Sandsara/Sandsara-3D/README.md

# Sandsara-3D
Welcome to Sandsara's 3D models repo! Here you can find the mechanism desing in stp. 



## License

<br />This work is licensed under a <a rel="license" href="http://creativecommons.org/licenses/by-nc-nd/4.0/">Creative Commons Attribution-NonCommercial-NoDerivatives 4.0 International License</a>
