Sandsara/Sandsara-3D/Arms/Main-Arm-REL1.stp

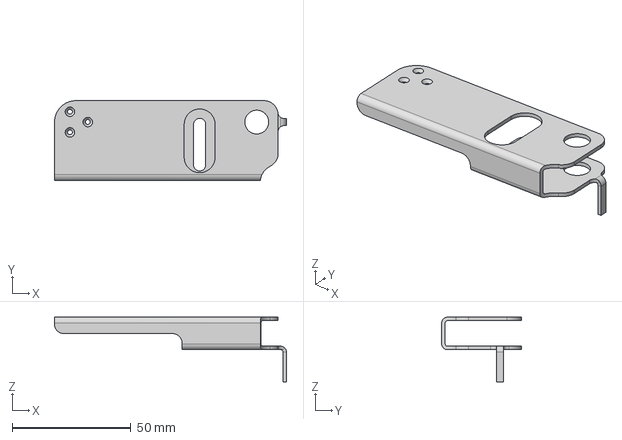
[picture p2: CAD file, 2021-05-29]
Arms/Main-Arm-REL1.stp
97.5 x 33.5 x 27.2 mm
