Sandsara/Sandsara-3D/Core/Main-Shaft-REL1.stp

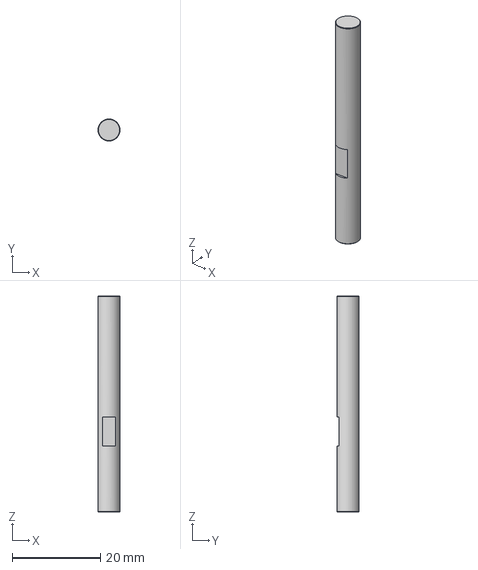
[picture p3: CAD file, 2021-05-29]
Core/Main-Shaft-REL1.stp
5.00 x 5.00 x 49.0 mm
