Sandsara/Sandsara-3D/Arms/Magnet-Arm-REL1.stp

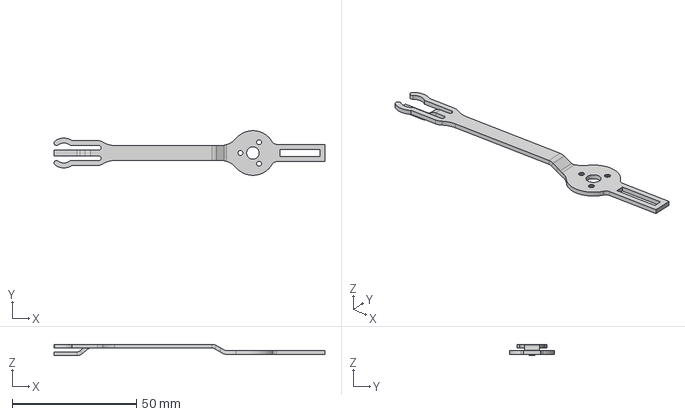
[picture p4: CAD file, 2021-05-29]
Arms/Magnet-Arm-REL1.stp
109.0 x 18.0 x 4.50 mm
