Sandsara/Sandsara-3D/Core/Pulley-40T-Bearing-REL1.stp

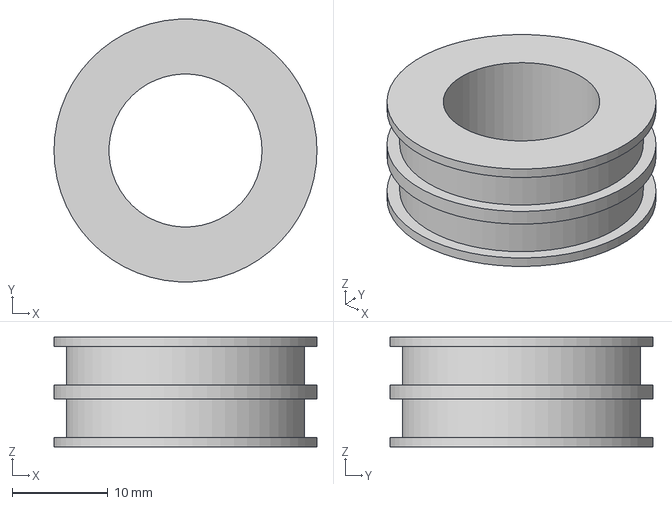
[picture p5: CAD file, 2021-05-29]
Core/Pulley-40T-Bearing-REL1.stp
27.5 x 27.5 x 11.5 mm
