Sandsara/Sandsara-3D/Core/Stepper-Holder-REL1.stp

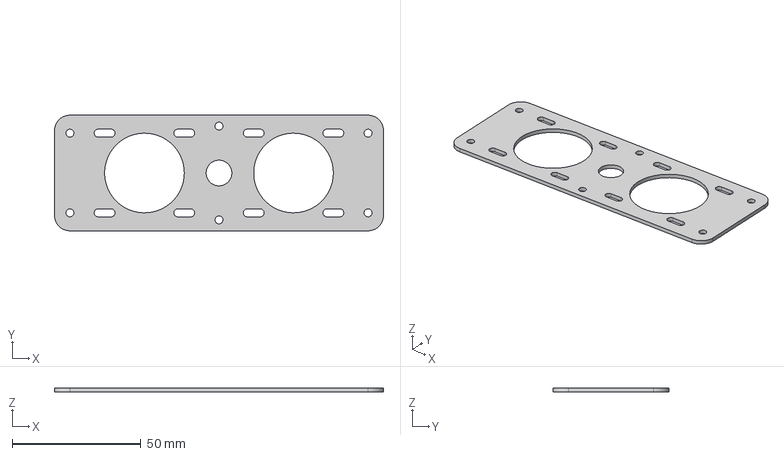
[picture p6: CAD file, 2021-05-29]
Core/Stepper-Holder-REL1.stp
128.0 x 45.0 x 1.59 mm
