Sandsara/Sandsara-3D/Arms/Magnet-Cap-REL1.stp

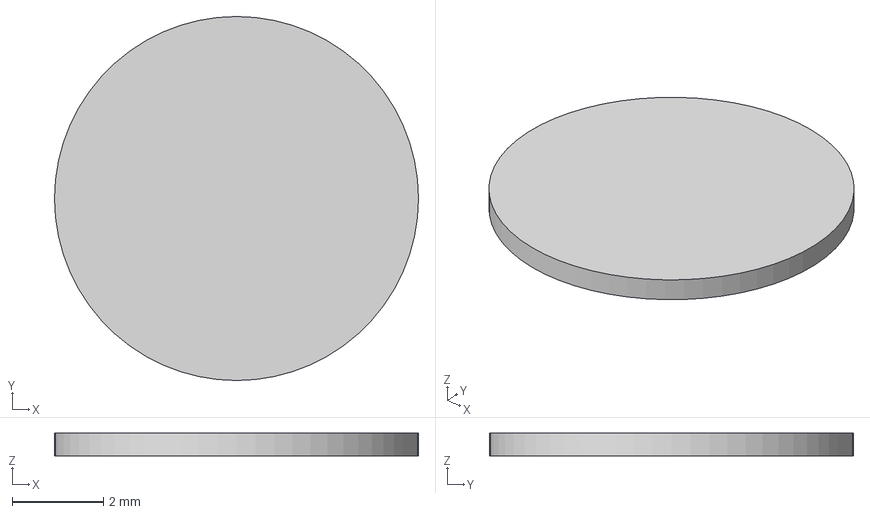
[picture p7: CAD file, 2021-05-29]
Arms/Magnet-Cap-REL1.stp
8.00 x 8.00 x 0.5 mm
