Sandsara/Sandsara-3D/Arms/Magnet-Large-REL1.stp

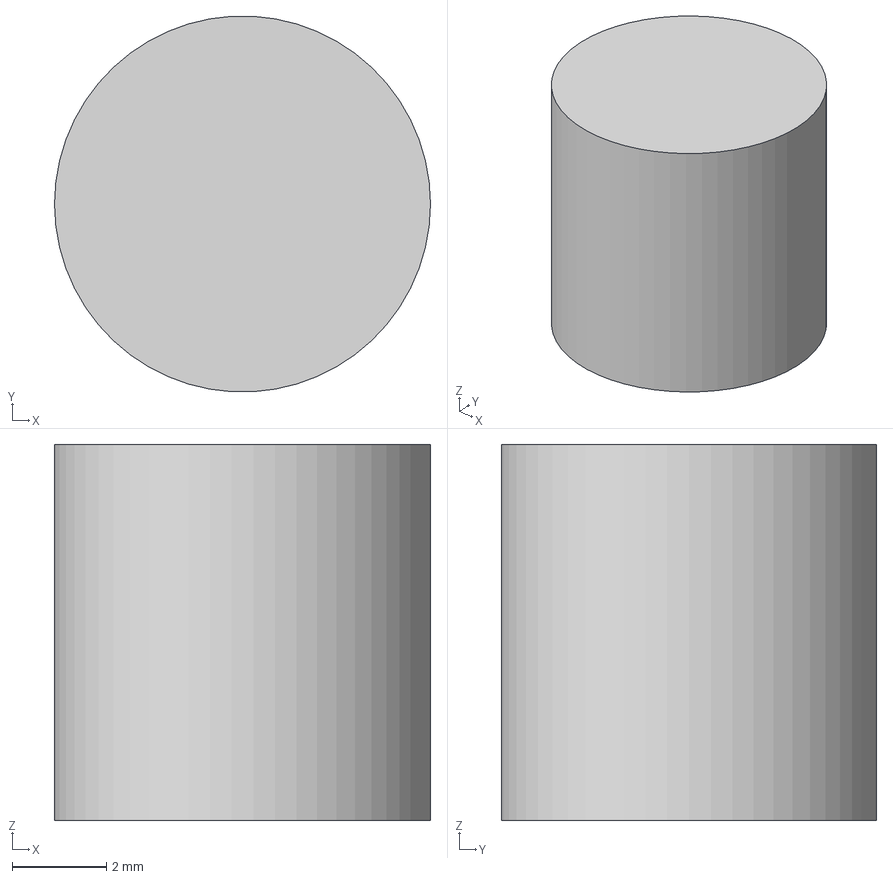
[picture p9: CAD file, 2021-05-29]
Arms/Magnet-Large-REL1.stp
8.00 x 7.99 x 8.00 mm
