Sandsara/Sandsara-3D/Core/Stepper-Motor-REL1.stp

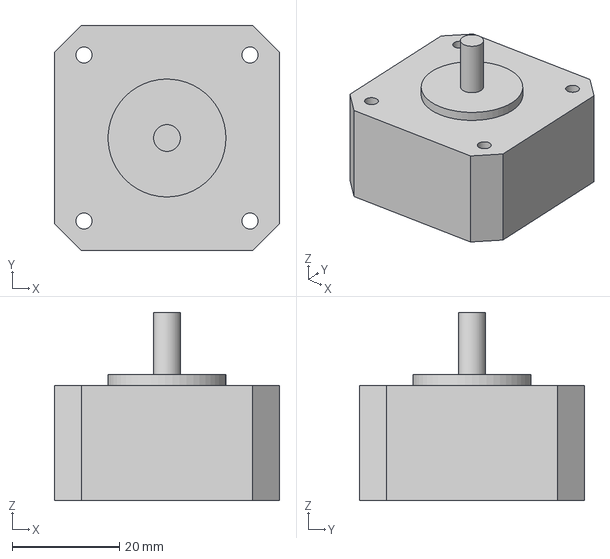
[picture p10: CAD file, 2021-05-29]
Core/Stepper-Motor-REL1.stp
42.0 x 42.0 x 35.1 mm
