Sandsara/Sandsara-3D/Arms/Secondary-Shaft-REL1.stp

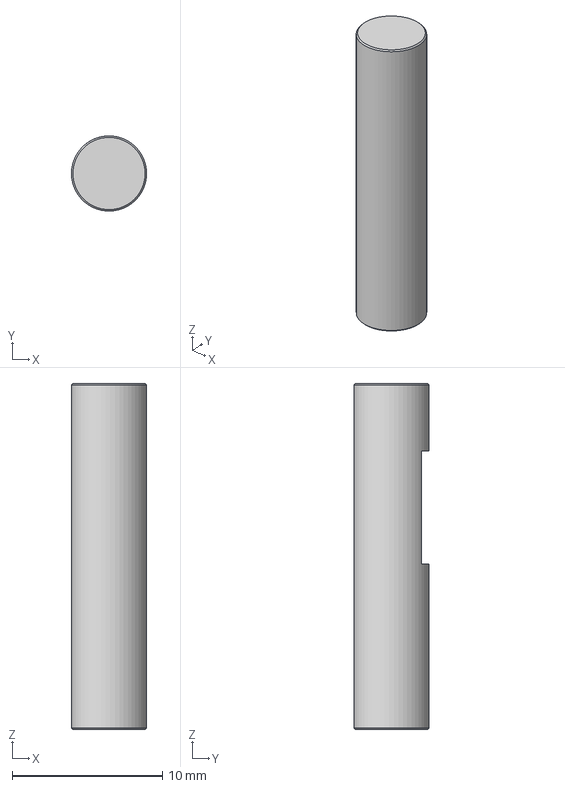
[picture p11: CAD file, 2021-05-29]
Arms/Secondary-Shaft-REL1.stp
5.00 x 5.00 x 23.0 mm
