Sandsara/Sandsara-3D/Arms/Magnet-Small-REL1.stp

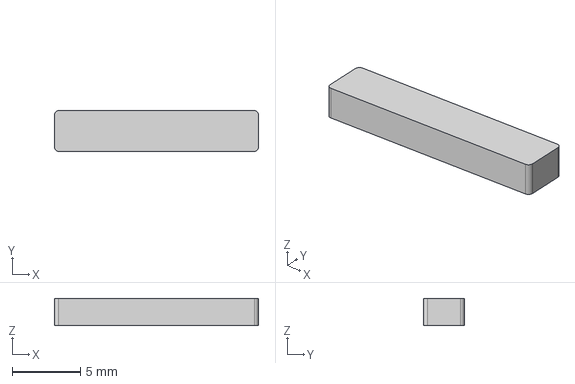
[picture p12: CAD file, 2021-05-29]
Arms/Magnet-Small-REL1.stp
15.0 x 3.00 x 2.00 mm
