Sandsara/Sandsara-3D/Core/Pulley-20T-REL1.stp

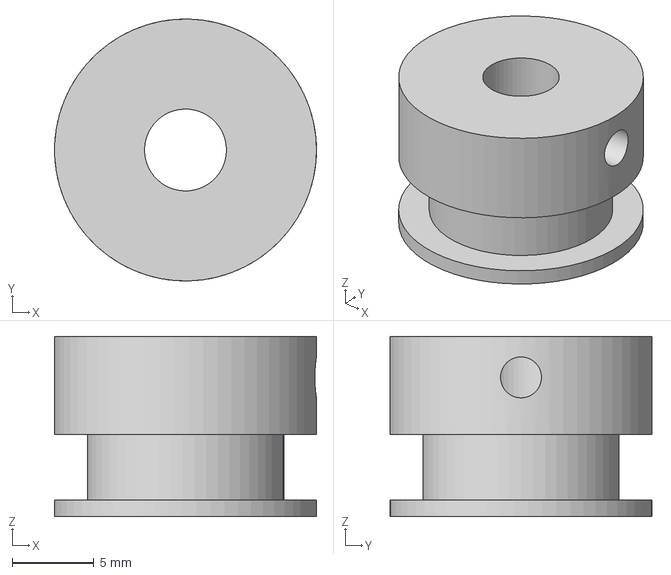
[picture p13: CAD file, 2021-05-29]
Core/Pulley-20T-REL1.stp
16.0 x 16.0 x 11.0 mm
