Sandsara/Sandsara-3D/Core/Pulley-40T-REL1.stp

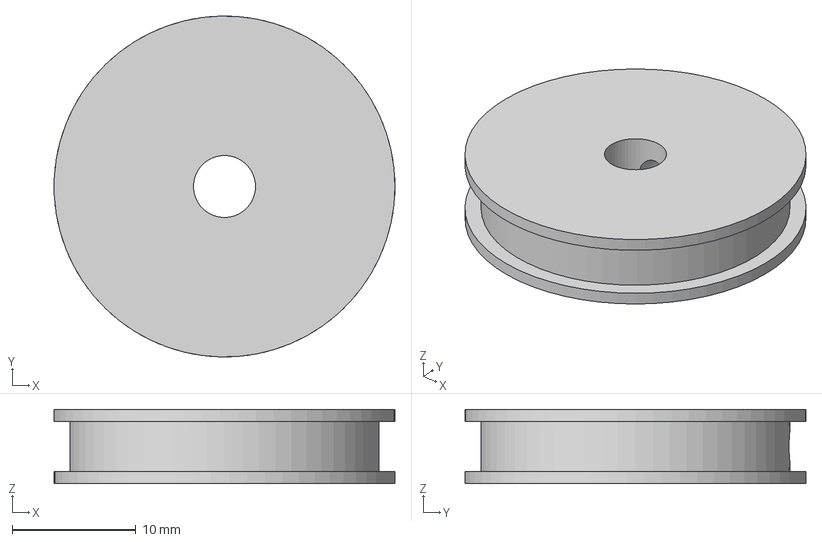
[picture p14: CAD file, 2021-05-29]
Core/Pulley-40T-REL1.stp
27.5 x 27.5 x 6.00 mm
