Sandsara/Sandsara-3D/Core/Spacer-Washer-Large-REL1.stp

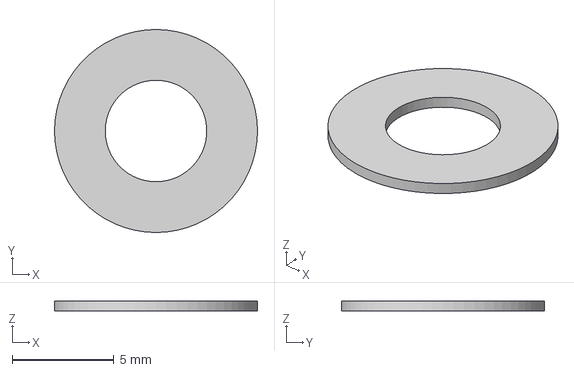
[picture p15: CAD file, 2021-05-29]
Core/Spacer-Washer-Large-REL1.stp
10.0 x 10.0 x 0.5 mm
