Sandsara/Sandsara-3D/Core/Spacer-Washer-REL1.stp

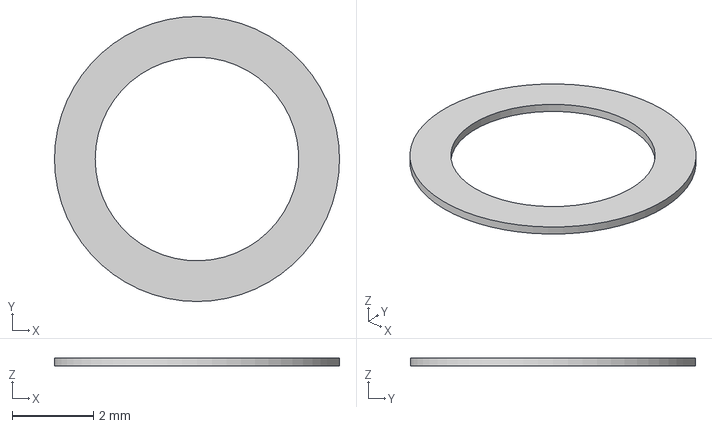
[picture p16: CAD file, 2021-05-29]
Core/Spacer-Washer-REL1.stp
7.00 x 7.00 x 0.2 mm
