Sandsara/Sandsara-3D/(threads)

Thread 1 (2021-06-05):

Question regarding endstop

maxvfischer, 2021-06-05:
Hi Ed and the rest of the team.

First, big congratz on your successful Kickstarter and for making the project open-source! I'm not a backer, but I've been following your progress during the last year. After seeing your initial prototypes, I got completely hooked on the idea and decided that it will be a great hobby project to build one myself from scratch. The process so far (I'm not done) took way longer than I thought, but I've learnt a lot! And you are the reason for that, so a big thank you :)

To my question. I've been trying to figure out a good way of solving the end-stop problem. In a normal cartesian robot/3d-printer, you can just move each axis to it's end-stop to know the positioning of the head. But in my (and your) case, the arms can spin indefinitely.

How have you solved this in your design? When I look at your 3d-models, I can't see an attachment for any type of end-stop. But maybe I'm just missing it?

My current best idea is to use hall effect sensors, one for each arm, and attach them next to the main shaft. Then I attach one magnet on each timing pulley (that are moving the two arms). The magnets are then aligned against the hall effect sensors when the arms are in an origo/center position. By doing so I can know when the arms are in origo.

First I tried using a digital hall effect sensor. But it's range was to wide and I couldn't get the optimal distance between the sensor and the magnet. It fired when the magnet arrived at ~5 degrees from center. This works but results in a quite large error margin.

My next idea was to use an analogue hall effect sensor instead and then measure when it peaks, thus knowing when the arms are exactly in origo. The problem with this is that I'm using a Raspberry Pi to do all logic, and it doesn't have an analogue input GPIO. I'm thinking about using a analogue-to-digital converter, but that will lead to two new chips in the solution, and I'm trying to keep the complexity down.

**My question:**
How did you solve the issue with end-stopping (knowing when the magnet is in origo)?

cumbaya1979, 2021-06-25:
Hey maxvfischer,

I am on the same way as you to build a sand-table.
My mechanical-parts are just completed and are working great.
They used an ESP32, so there are analogue Input ports on-board.
As you can see in the firmware-repository, they are using analogue hall-sensors to archieve to get the minimum distance between arm and sensor.
Cheers, Timo
